abmfy/digital-design-grp-12/(commit log)

2021-05-08 Update sd card pins for board rev 2114
2021-05-09 Fix sdram data bus direction
    [mod_top.sv]
2023-05-09 feat: update frame based on next state
2023-05-10 feat: read and display sensor raw data
2023-05-14 feat(sensor): add motion detector
2023-05-18 fix: set COOR_WIDTH to 12
    [mod_top.sv]
2023-05-18 feat(paint_demo): respond to sensor
2023-05-18 feat: fill unpainted slots
2023-05-18 fix: no paiting outside screen border
    [mod_top.sv]
2023-05-24 fix: sample reset button with 2 regs
    [mod_top.sv]
2023-05-24 fix(sensor): use PLL instead of frequency division for UART
    [async_receiver_sim.sv, mod_top.sv, sensor_sim.sv]
2023-05-26 feat: input mode switch
2023-05-26 feat: seed rng with current time
2023-05-29 fix: adjust button input
    右边的按钮按起来方便一些，左边和 clock_btn 太近了
    [mod_top.sv]
2023-05-29 fix(vga): buffer sync and de outputs
2023-05-29 test(sensor): fix simulation
2023-06-04 fix: use 6-bit night rate
    [mod_top.sv]
2023-06-04 feat: slow mode when playing with sensor
2023-06-04 feat: restart timer
2023-06-05 Revert "fix(vga): fix background output timing"
    This reverts commit df2d8e6c04377840562fa8492b23411390f514df.
    read_enable 和 read_red 这些隔了几个时钟周期，这样写在屏幕边界应该会挂？
2023-06-05 fix: add buffer for jump and duck button
    [mod_top.sv]
2023-06-06 feat: only 1 life in button mode
2023-06-06 fix: buffer sensor_mode to fix timing
    [mod_top.sv]
2023-06-20 fix(async_receiver): sample at middle of a bit
2023-06-20 docs: add more on UART and sensor & simulation results & minor changes
2023-06-20 docs: clarify next_byte
    1. 实际上是可以说是读完包括开始的 0 在内的 9 个 bit
    2. 不是一个 bit 的时间，而是一个时钟周期，即 1/8 个 bit 的时间
